IvanKenevich/furuta-pendulum/docs/TB9051FTG_pinout.jpg

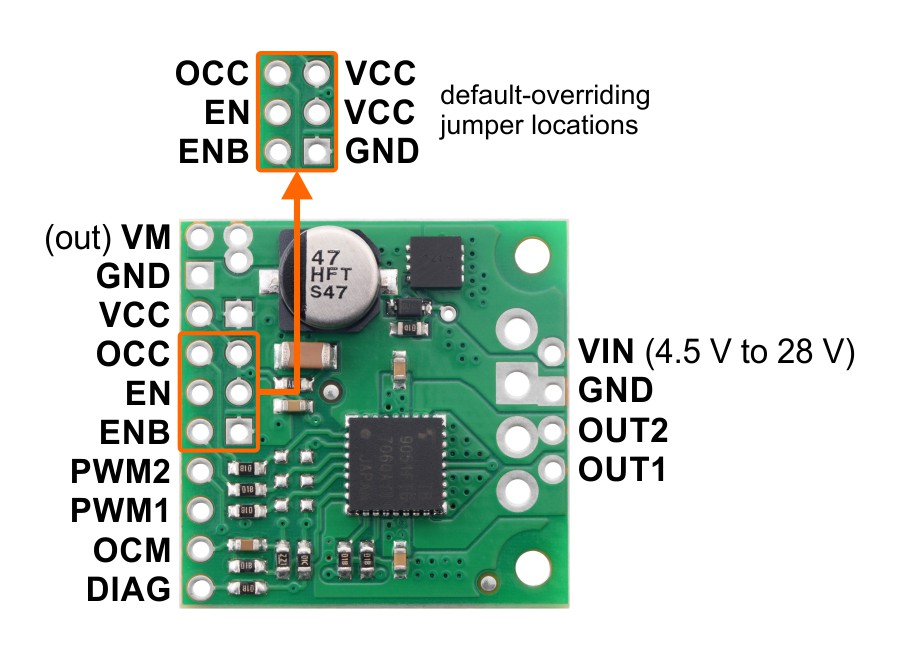
docs/TB9051FTG_pinout.jpg
