IvanKenevich/furuta-pendulum/README.md

# furuta-pendulum

Inverted rotary pendulum
