IvanKenevich/furuta-pendulum/code/MATLAB/motor_freq_response/response_amplitudes.png

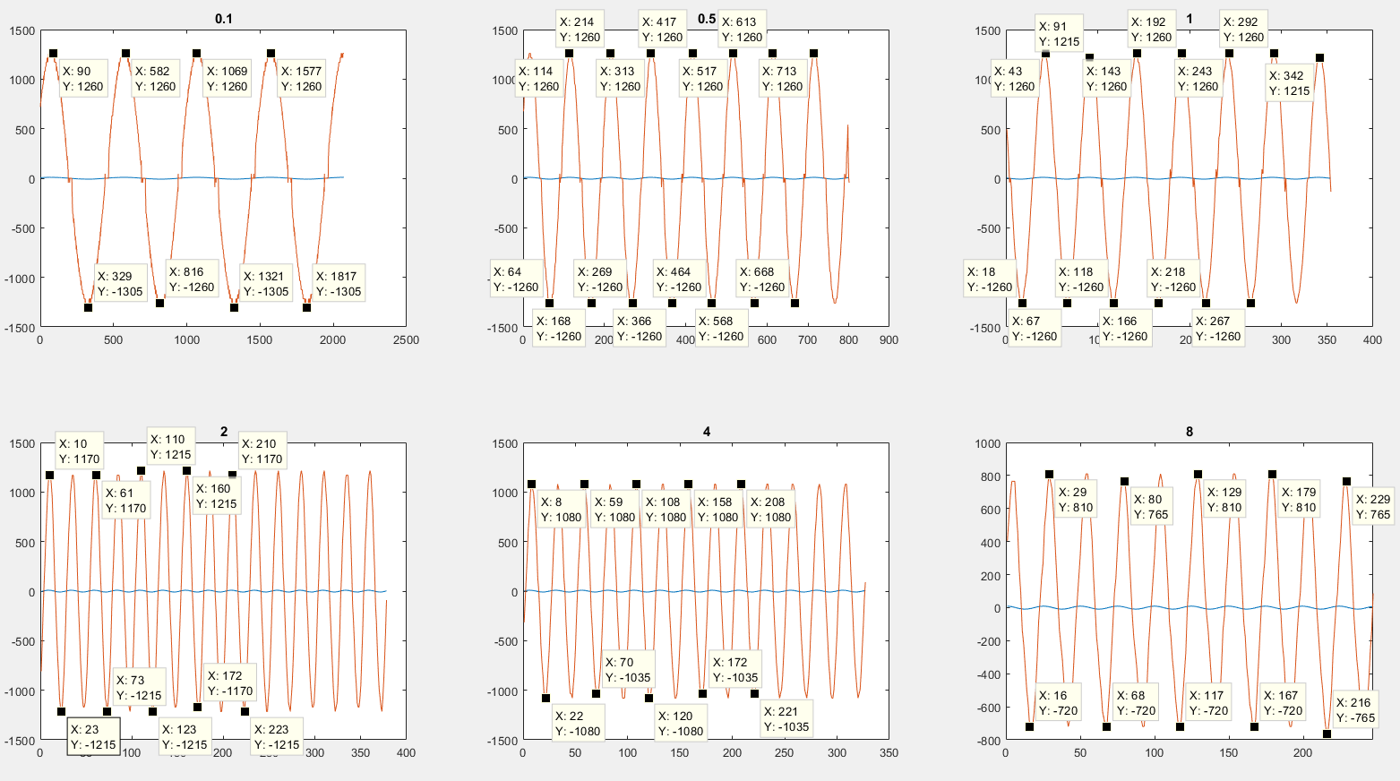
code/MATLAB/motor_freq_response/response_amplitudes.png
