IvanKenevich/furuta-pendulum/code/motor_freq_response/0.1hz_8.58v.png

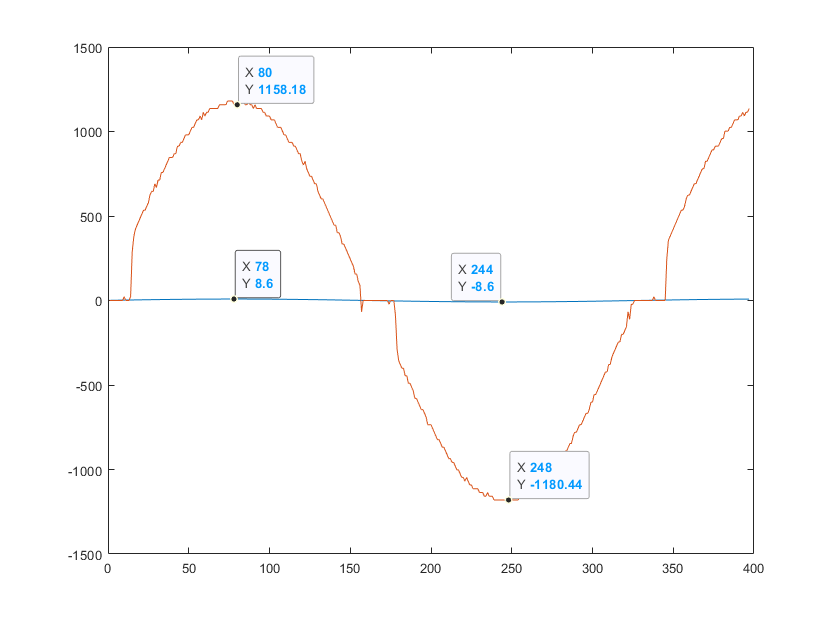
code/motor_freq_response/0.1hz_8.58v.png
