IvanKenevich/furuta-pendulum/code/motor_freq_response/0.5hz_5v.png

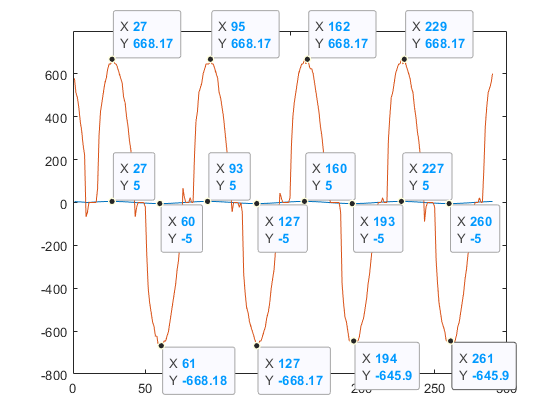
code/motor_freq_response/0.5hz_5v.png
