IvanKenevich/furuta-pendulum/code/motor_freq_response/1hz_5v_phase.png

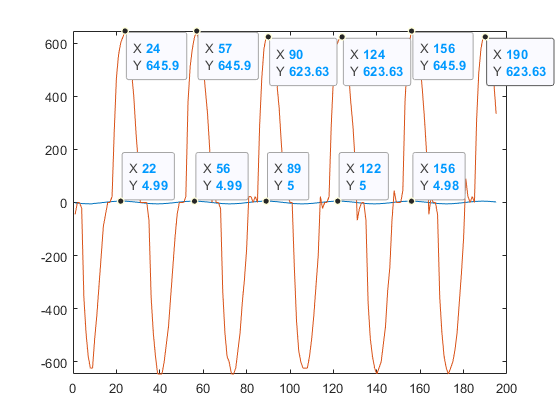
code/motor_freq_response/1hz_5v_phase.png
