IvanKenevich/furuta-pendulum/code/motor_freq_response/2hz_5v.png

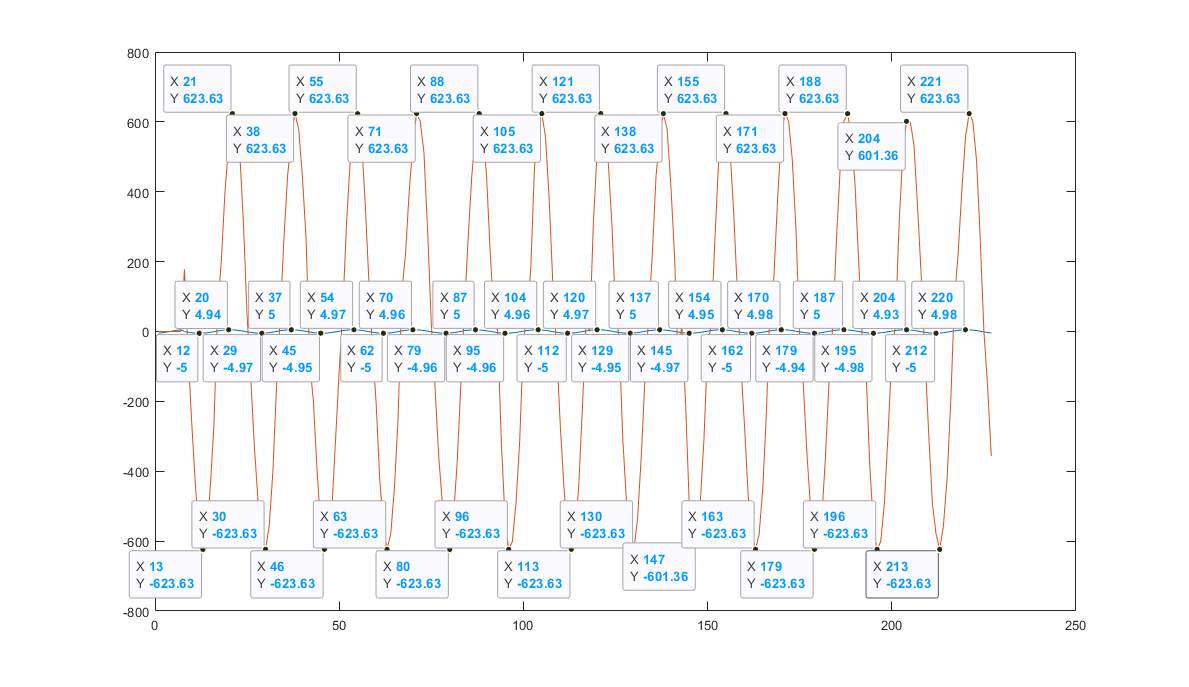
code/motor_freq_response/2hz_5v.png
