IvanKenevich/furuta-pendulum/cad/AMT10/CUI_DEVICES_CUI_DEVICES_AMT103-D0048-I3000-S.sldasm

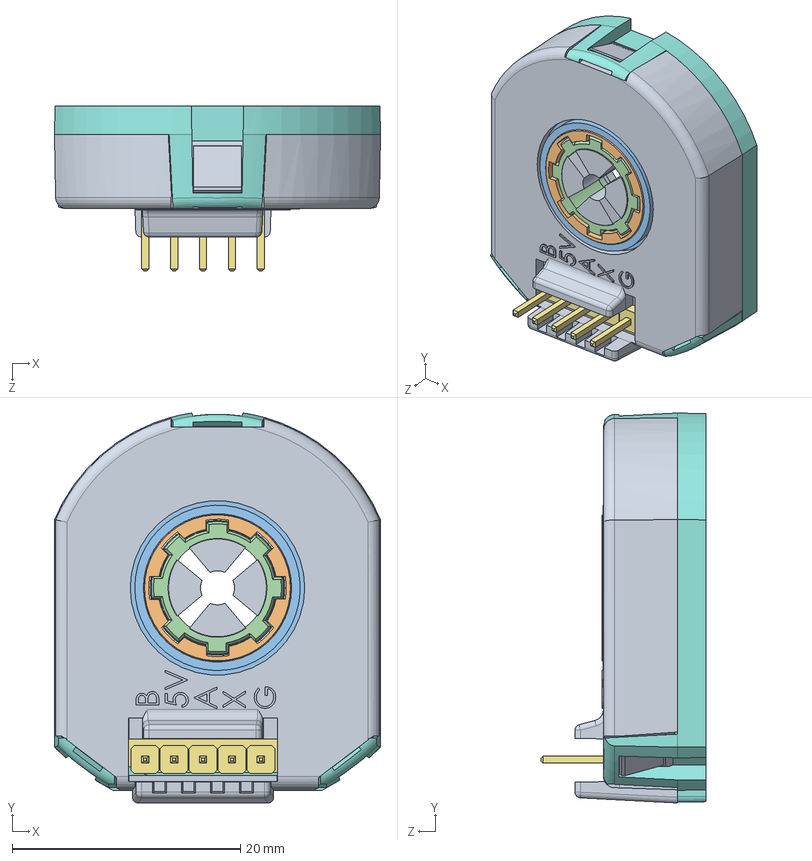
[picture p12: CAD file, 2023-09-13]
cad/AMT10/CUI_DEVICES_CUI_DEVICES_AMT103-D0048-I3000-S.sldasm
28.6 x 34.2 x 14.5 mm
CUI_DEVICES_AMT-Sleeve-REV-D(3 mm)
CUI_DEVICES_AMT-Hub-Top-REV-D1
CUI_DEVICES_AMT-Hub-Bottom-REV-B
CUI_DEVICES_AMT10X-Shaft-Adaptor-REV-E
CUI_DEVICES_Receiver-board
CUI_DEVICES_Rotor-board-REV F
CUI_DEVICES_Transmitter-board AMT10(AMT-103)
CUI_DEVICES_AMT-103-Base-REV-K(Default)
CUI_DEVICES_AMT-103-Top-Cover-REV-I
