IvanKenevich/furuta-pendulum/cad/arm1_assembly.SLDASM

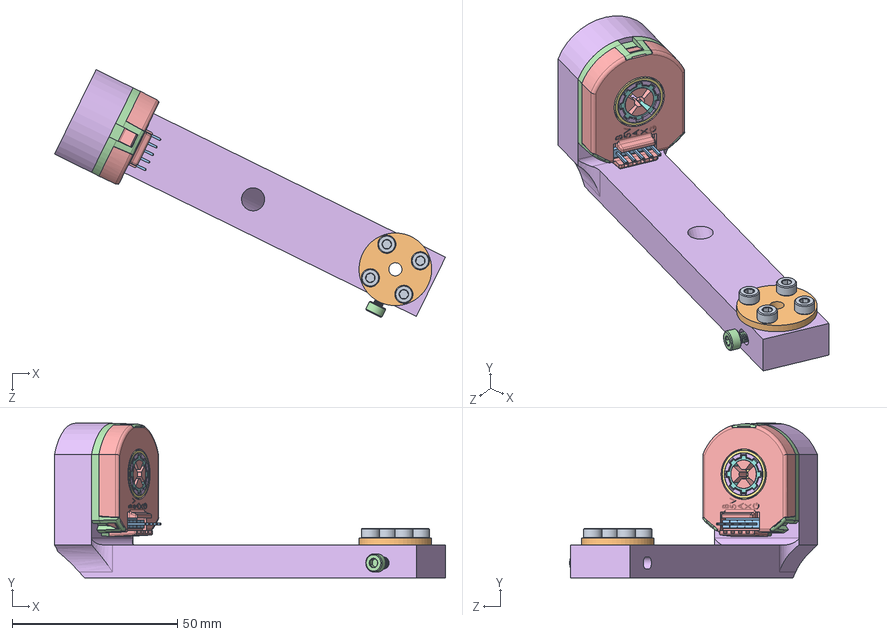
[picture p13: CAD file, 2023-09-13]
cad/arm1_assembly.SLDASM
118.4 x 46.8 x 75.0 mm
M3-12 x 4
M4 Shaft Coupler
M3 Nut x 4
M3-10
CUI_DEVICES_AMT-Sleeve-REV-D(3 mm)
CUI_DEVICES_AMT-Hub-Top-REV-D1
CUI_DEVICES_AMT-Hub-Bottom-REV-B
CUI_DEVICES_AMT10X-Shaft-Adaptor-REV-E
CUI_DEVICES_Receiver-board
CUI_DEVICES_Rotor-board-REV F
CUI_DEVICES_Transmitter-board AMT10(AMT-103)
CUI_DEVICES_AMT-103-Base-REV-K(Default)
CUI_DEVICES_AMT-103-Top-Cover-REV-I
Copy of Part2^arm1_assembly
8mm_bearing
