IvanKenevich/furuta-pendulum/cad/pcb/LM78L05ACZ_NOPB/LM78L05ACZ_NOPB.step

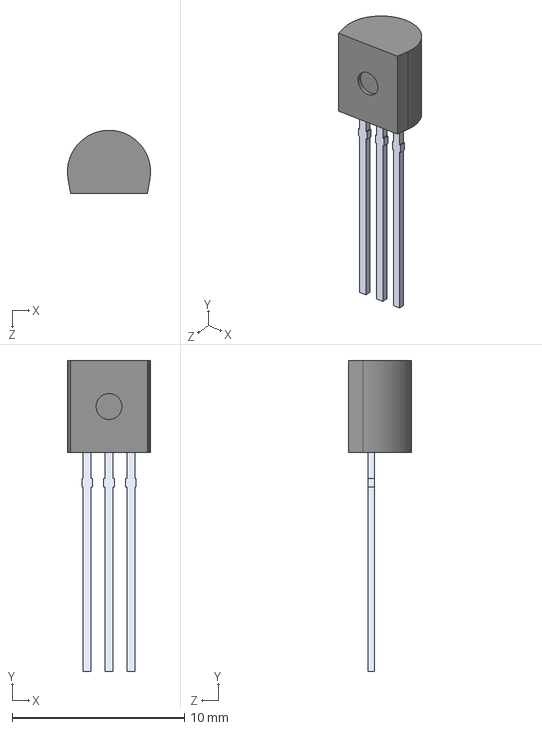
[picture p14: CAD file, 2025-07-25]
cad/pcb/LM78L05ACZ_NOPB/LM78L05ACZ_NOPB.step
4.82 x 18.0 x 3.68 mm
