IvanKenevich/furuta-pendulum/cad/Slip_Ring_B07XMJT65N.SLDPRT

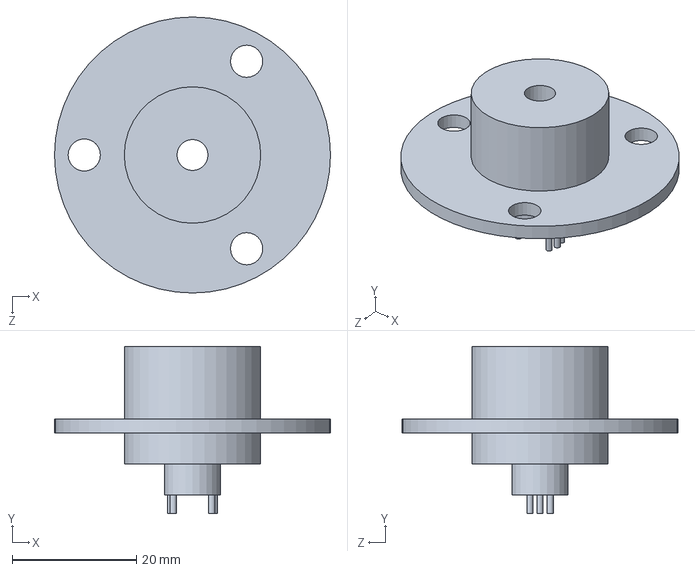
[picture p15: CAD file, 2023-09-13]
cad/Slip_Ring_B07XMJT65N.SLDPRT
44.5 x 27.0 x 44.5 mm
