IvanKenevich/furuta-pendulum/cad/M4 Shaft Coupler.SLDPRT

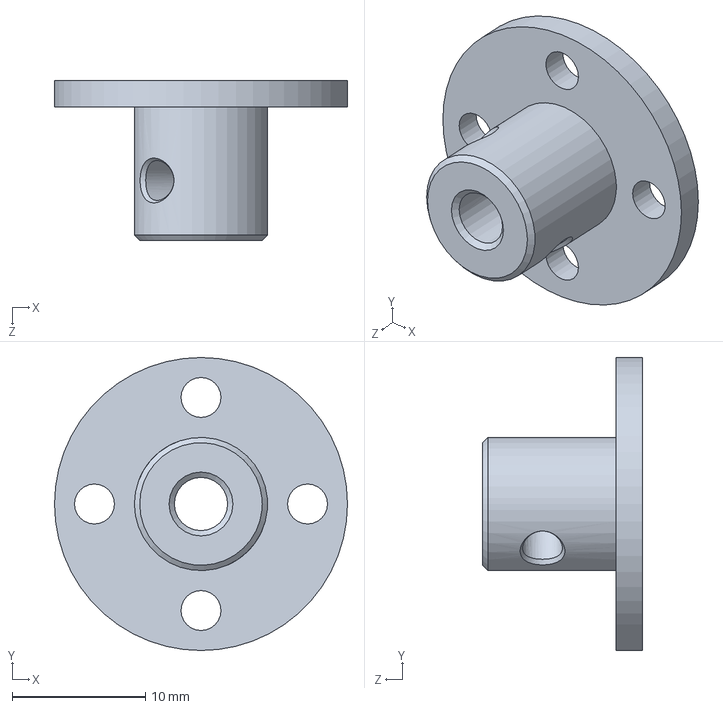
[picture p16: CAD file, 2023-09-13]
cad/M4 Shaft Coupler.SLDPRT
22.0 x 22.0 x 12.0 mm
