IvanKenevich/furuta-pendulum/cad/25d-metal-gearmotor-34-47-encoder.step.SLDPRT

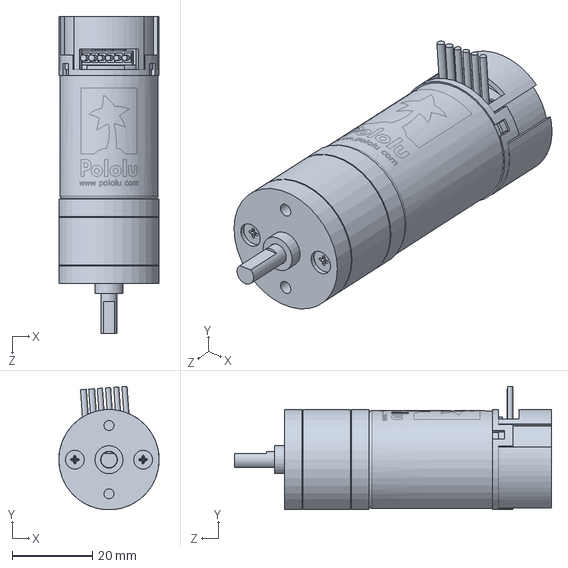
[picture p17: CAD file, 2023-09-13]
cad/25d-metal-gearmotor-34-47-encoder.step.SLDPRT
25.0 x 30.7 x 78.9 mm
