IvanKenevich/furuta-pendulum/cad/8mm_bearing.SLDPRT

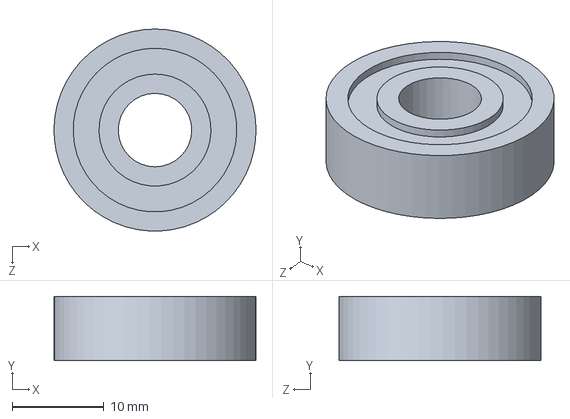
[picture p18: CAD file, 2023-09-13]
cad/8mm_bearing.SLDPRT
22.0 x 7.00 x 22.0 mm
