IvanKenevich/furuta-pendulum/cad/arm2_combined.SLDPRT

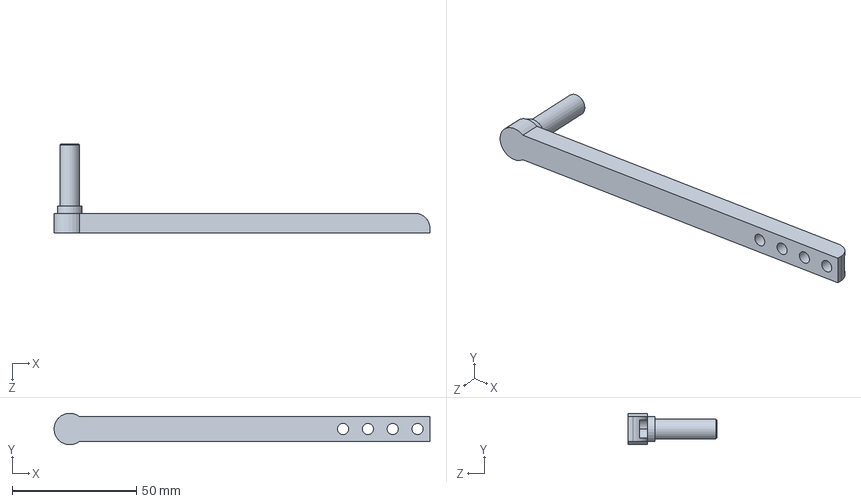
[picture p19: CAD file, 2023-09-13]
cad/arm2_combined.SLDPRT
151.3 x 12.7 x 36.0 mm
