IvanKenevich/furuta-pendulum/cad/M4 socket heads.SLDPRT

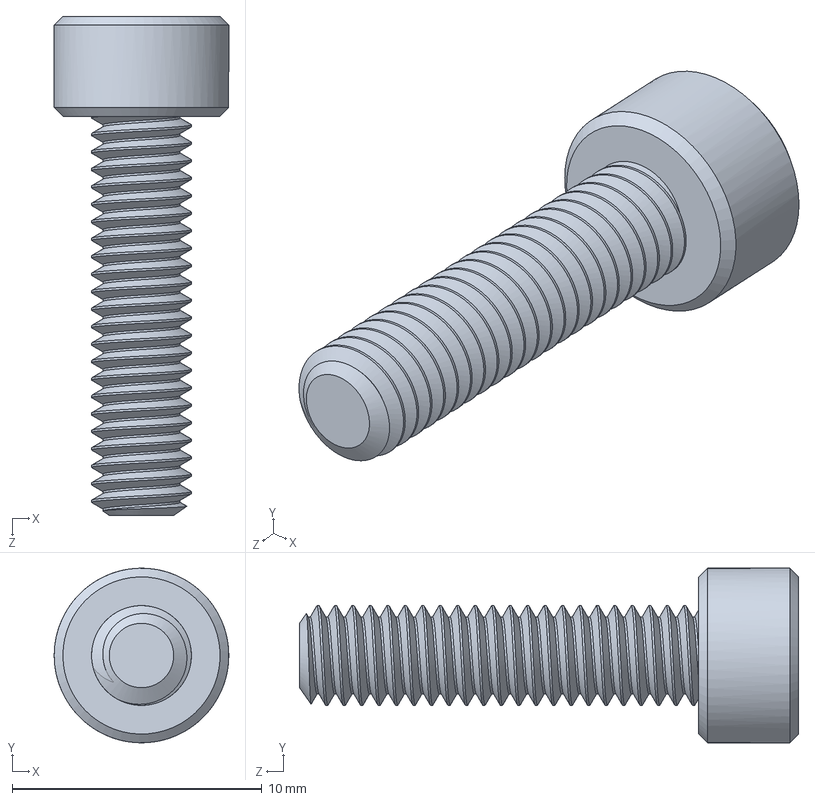
[picture p20: CAD file, 2023-09-13]
cad/M4 socket heads.SLDPRT
7.00 x 7.00 x 20.0 mm
