IvanKenevich/furuta-pendulum/cad/acrylic_base.SLDPRT

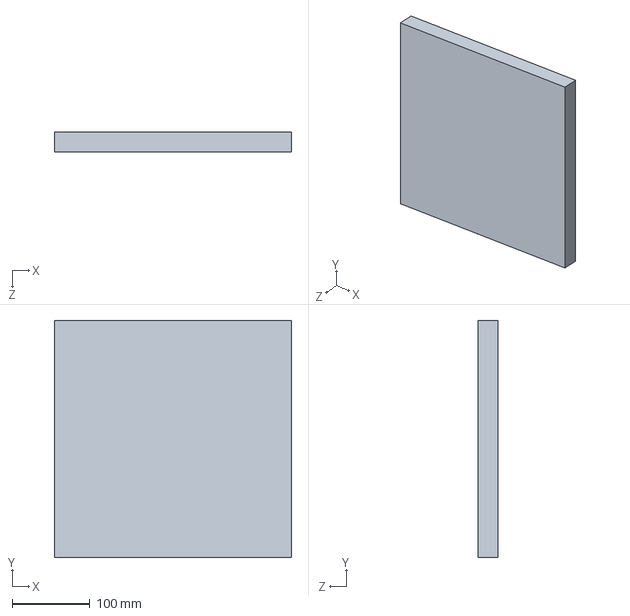
[picture p21: CAD file, 2023-09-13]
cad/acrylic_base.SLDPRT
304.8 x 304.8 x 25.4 mm
