IvanKenevich/furuta-pendulum/cad/shaft_coupler.SLDPRT

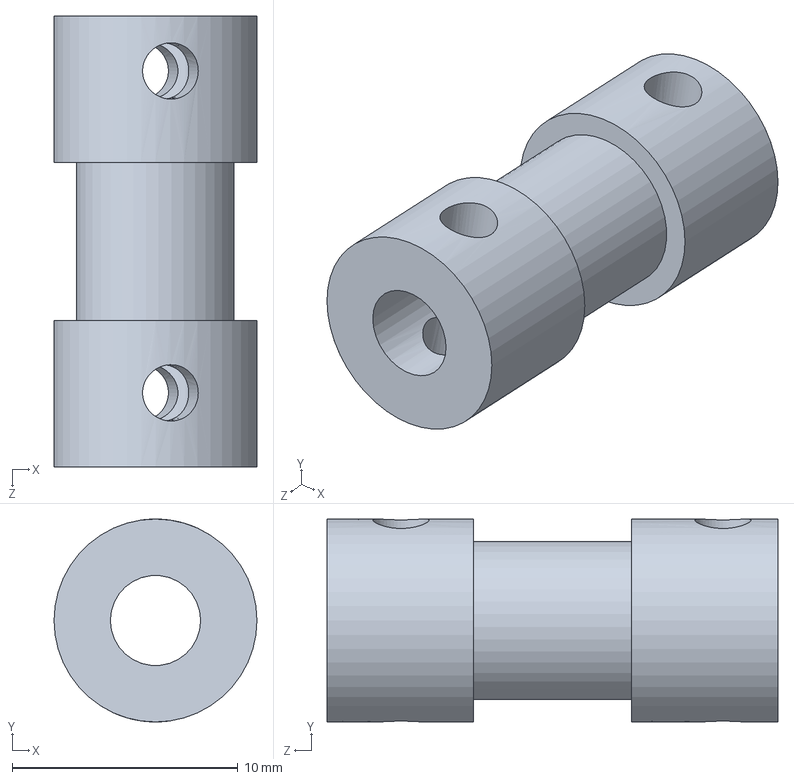
[picture p22: CAD file, 2023-09-13]
cad/shaft_coupler.SLDPRT
9.00 x 9.00 x 20.0 mm
