IvanKenevich/furuta-pendulum/cad/top plate.SLDPRT

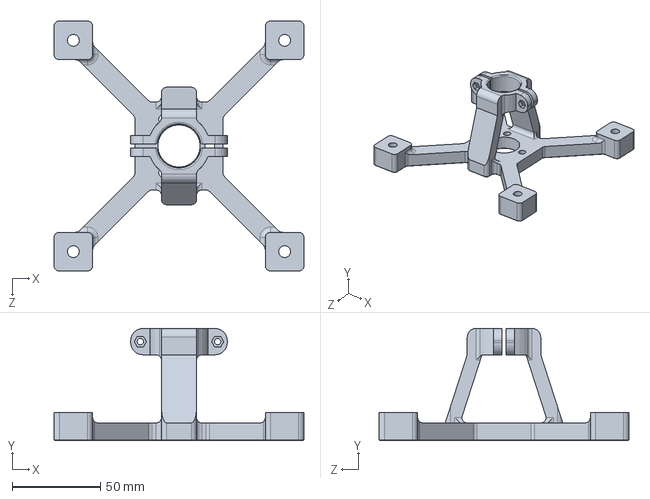
[picture p23: CAD file, 2023-08-10]
cad/top plate.SLDPRT
142.0 x 63.7 x 142.0 mm
