IvanKenevich/furuta-pendulum/cad/6436K5_Clamping Two-Piece Shaft Collar.SLDPRT

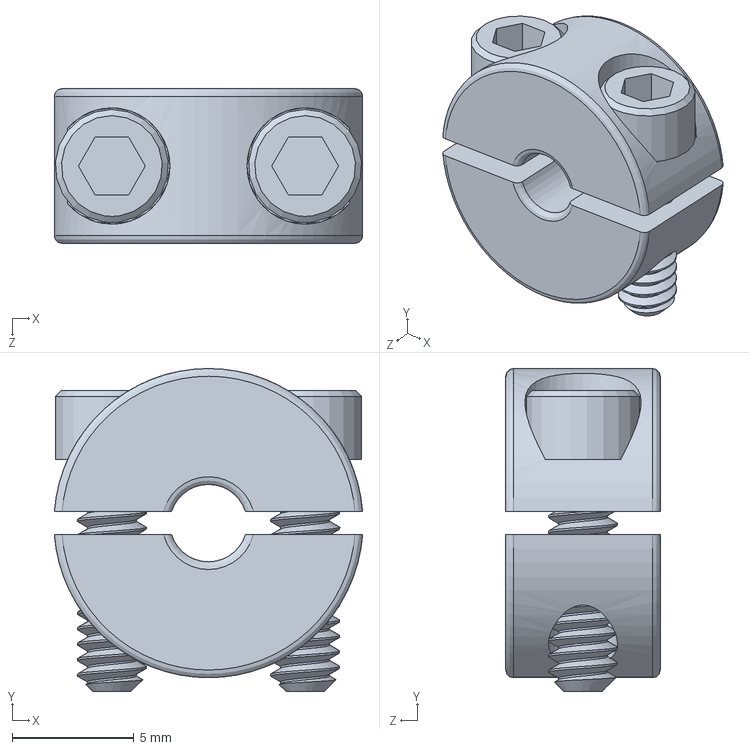
[picture p24: CAD file, 2023-06-01]
cad/6436K5_Clamping Two-Piece Shaft Collar.SLDPRT
12.7 x 13.3 x 6.35 mm
