IvanKenevich/furuta-pendulum/cad/spacer_disk.SLDPRT

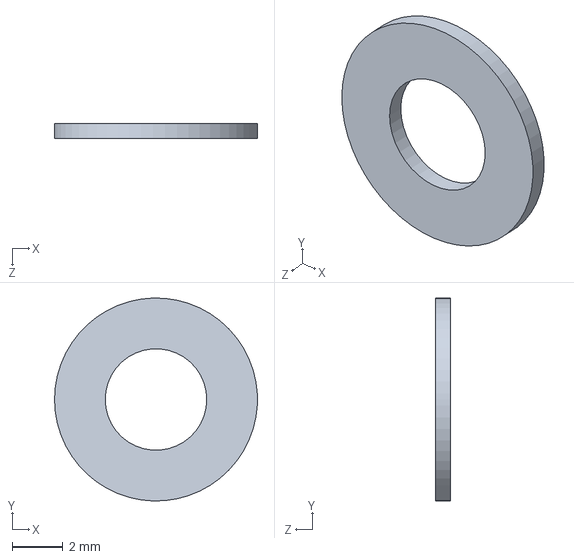
[picture p25: CAD file, 2023-05-31]
cad/spacer_disk.SLDPRT
8.00 x 8.00 x 0.6 mm
