IvanKenevich/furuta-pendulum/cad/bottom plate.SLDPRT

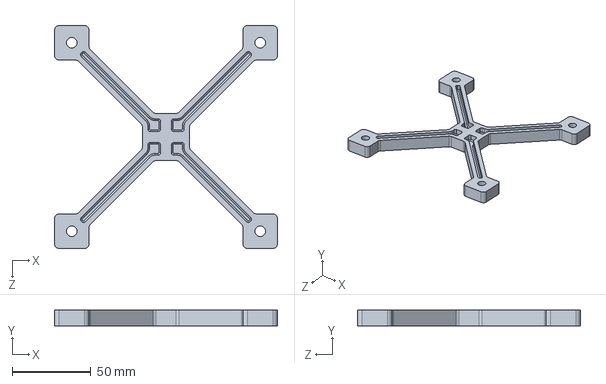
[picture p26: CAD file, 2023-05-23]
cad/bottom plate.SLDPRT
142.0 x 10.0 x 142.0 mm
