IvanKenevich/furuta-pendulum/cad/pololu-universal-aluminum-mounting-hub-for-4mm-shaft-m3-holes.step

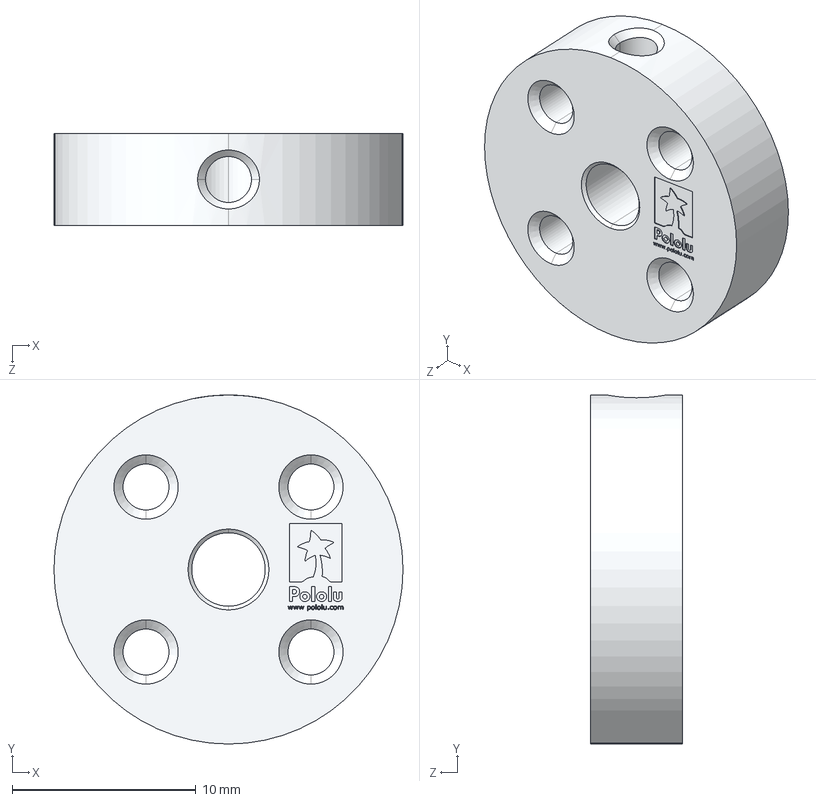
[picture p27: CAD file, 2023-05-05]
cad/pololu-universal-aluminum-mounting-hub-for-4mm-shaft-m3-holes.step
19.0 x 19.0 x 5.00 mm
