IvanKenevich/furuta-pendulum/cad/mending bracket.SLDPRT

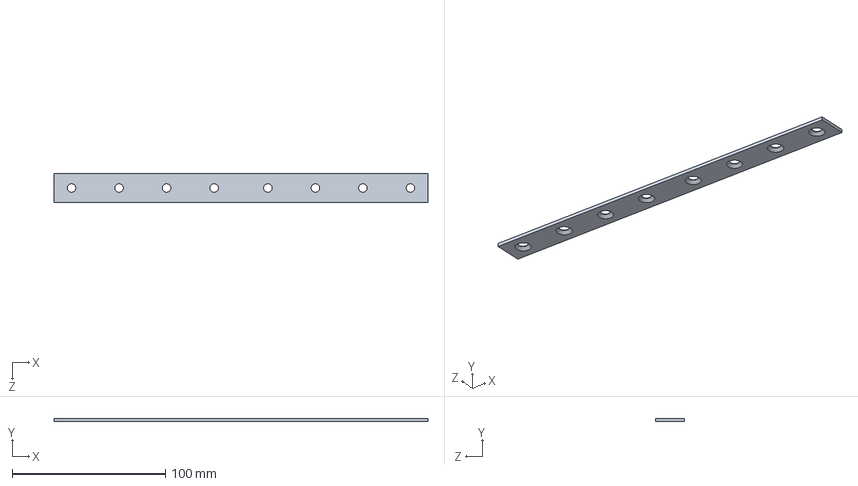
[picture p28: CAD file, 2023-05-05]
cad/mending bracket.SLDPRT
243.8 x 2.03 x 19.1 mm
