IvanKenevich/furuta-pendulum/cad/arm2_assembly.SLDASM

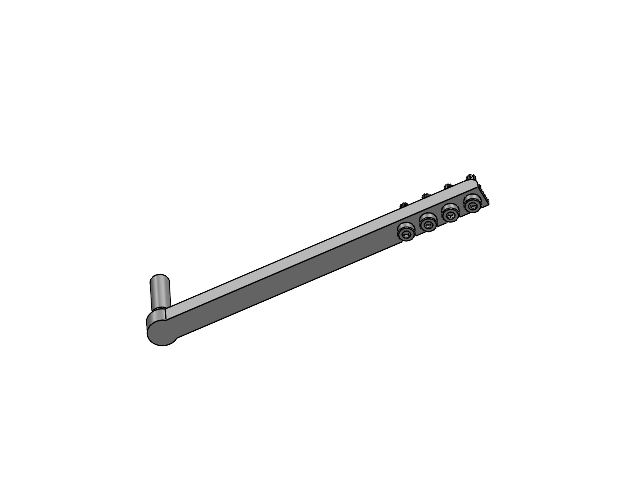
[picture p29: CAD file, 2023-09-13]
cad/arm2_assembly.SLDASM
arm2_combined
M4 Nut x 4
M4 socket heads x 4
