IvanKenevich/furuta-pendulum/(list of files, cad)

Other CAD files:
cad/AMT10/CUI_DEVICES_AMT-Sleeve-REV-D(3 mm).sldprt
cad/AMT10/CUI_DEVICES_AMT-103-Top-Cover-REV-I.sldprt
cad/AMT10/CUI_DEVICES_AMT-Hub-Top-REV-D1.sldprt
cad/AMT10/CUI_DEVICES_Receiver-board.sldprt
cad/AMT10/CUI_DEVICES_AMT-103-Base-REV-K(Default).sldprt
cad/AMT10/CUI_DEVICES_AMT10X-Shaft-Adaptor-REV-E.sldprt
cad/AMT10/CUI_DEVICES_AMT-Hub-Bottom-REV-B.sldprt
cad/AMT10/CUI_DEVICES_Rotor-board-REV F.sldprt
cad/AMT10/CUI_DEVICES_Transmitter-board AMT10(AMT-103).sldprt
cad/25d-metal-gearmotor-34-47-encoder.step
cad/1327K93_Rotary Shaft.SLDPRT
cad/5544T231_Tight-Tolerance 12L14 Carbon Steel Rod.SLDPRT
cad/6103K24_Swivel Leveling Mount.SLDPRT
cad/6338K561_Oil-Embedded Flanged Sleeve Bearing.SLDPRT
cad/6436K12_Clamping Two-Piece Shaft Collar.SLDPRT
cad/8632T132_D-Profile Rotary Shaft.SLDPRT
cad/8920K181_Low-Carbon Steel Rod.SLDPRT
cad/8961K87_Steel DIN 3 Rail.SLDPRT
cad/90281A102_Black-Oxide Steel Setup Stud.SLDPRT
cad/90490A029_Low-Strength Steel Hex Nut.SLDPRT
cad/91290A111_Alloy Steel Socket Head Screw.SLDPRT
cad/M3 Nut.SLDPRT
cad/M3-10.SLDPRT
cad/M3-12.SLDPRT
cad/M4 Nut.SLDPRT
cad/top plate_v1.SLDPRT
