IvanKenevich/furuta-pendulum/(threads)

Thread 1 (2023-10-03):

Try classical controller

IvanKenevich, 2023-10-03:
Design PID and compare with state space

IvanKenevich, 2024-01-26:
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

IvanKenevich, 2024-01-26:
Need to find Ps from equations of motion (linearize). Cs are designed with classical controller design methods.
R_theta2 = 0 always.

This seems like a better method than trying to extract theta_2 transfer function using `ss2tf()`.

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

IvanKenevich, 2024-01-30:
$P_{\theta_2}$ appears plausible to find. Use derived kinematics of linear inverted pendulum to skip that math and see if you can go strait to transfer function of $\theta_2/\dot{\theta}_1$

IvanKenevich, 2024-02-01:
From the math, it turns out

$\displaystyle\frac{\theta_2}{\dot{\theta}_1} = $

$\displaystyle\frac{L_1 m l_{2}s^3}{(J_{2zz-cg}+m l_{2}^2)s^2 + b_2 s - mg l_{2}}$

IvanKenevich, 2025-03-03:
Evaluate later after doing other things

Thread 12 (2023-10-03):

Dual motor system

IvanKenevich, 2023-10-03:
one with high torque and backlash, other with low torque no backlash, have benefits of both

Thread 13 (2023-10-03):

Dual motor system

IvanKenevich, 2023-10-03:
opposing motors with anti-backlash hardware

IvanKenevich, 2025-03-04:
Do some dedicated thinking about this to tell if this is dumb or not. Not specific to this project.

Thread 14 (2023-10-03):

Single direct drive motor

IvanKenevich, 2023-10-03:
Get rid of backlash by getting a direct drive motor that works.

Closed 2025-03-04.

Thread 15 (2023-10-03):

Precision gearbox

IvanKenevich, 2023-10-03:
Buy a gearbox that has high precision to reduce backlash

IvanKenevich, 2025-03-04:
Do some dedicated thinking about this to tell if this is dumb or not. Not specific to this project.

Closed 2025-03-04.

Thread 16 (2023-10-03):

Investigate more different ways of measuring motor parameters

IvanKenevich, 2023-10-03:
measure each par manually and compare to freq response solved versions

ask on stack exchange: does the motor have the same friction coeffficent when power or unpowered

IvanKenevich, 2025-03-03:
Look into which motor parameters we can measure manually and how trustworthy the measurements would be.

Try finding the answer to second question (ChatGPT?)

Thread 19 (2023-10-03):

Learn how to model nonlinearities

IvanKenevich, 2023-10-03:
backlash, stiction

IvanKenevich, 2025-03-03:
Model on a simplified system - motor with inertia wheel. Make sure simulation matches reality.

Thread 3 (2023-10-03):

Non-linear controller

IvanKenevich, 2023-10-03:
Compare performance to linear

IvanKenevich, 2025-03-04:
Another project. If you want, look into cancelling backlash with your controller on this project to improve performance.

Closed 2025-03-04.

Thread 4 (2023-10-03):

Modulo arm 1

IvanKenevich, 2023-10-03:
60 degree modulo. Make sure it resets upon swingup (there is currently a bug where it uses reference variable and does not reset).

IvanKenevich, 2025-03-03:
Run it, see how it works

Thread 8 (2023-10-03):

Investigate why current matters for furuta but not RWIP

IvanKenevich, 2023-10-03:
look at the magnitudes of torques/delta Is/whatever that are caused by the current state variable

IvanKenevich, 2025-03-04:
Look at it.
