IvanKenevich/furuta-pendulum/cad/pcb/furuta-pendulum-pcb.kicad_pcb

## KiCad design cad/pcb/furuta-pendulum-pcb.kicad_pcb (2025-12-10)

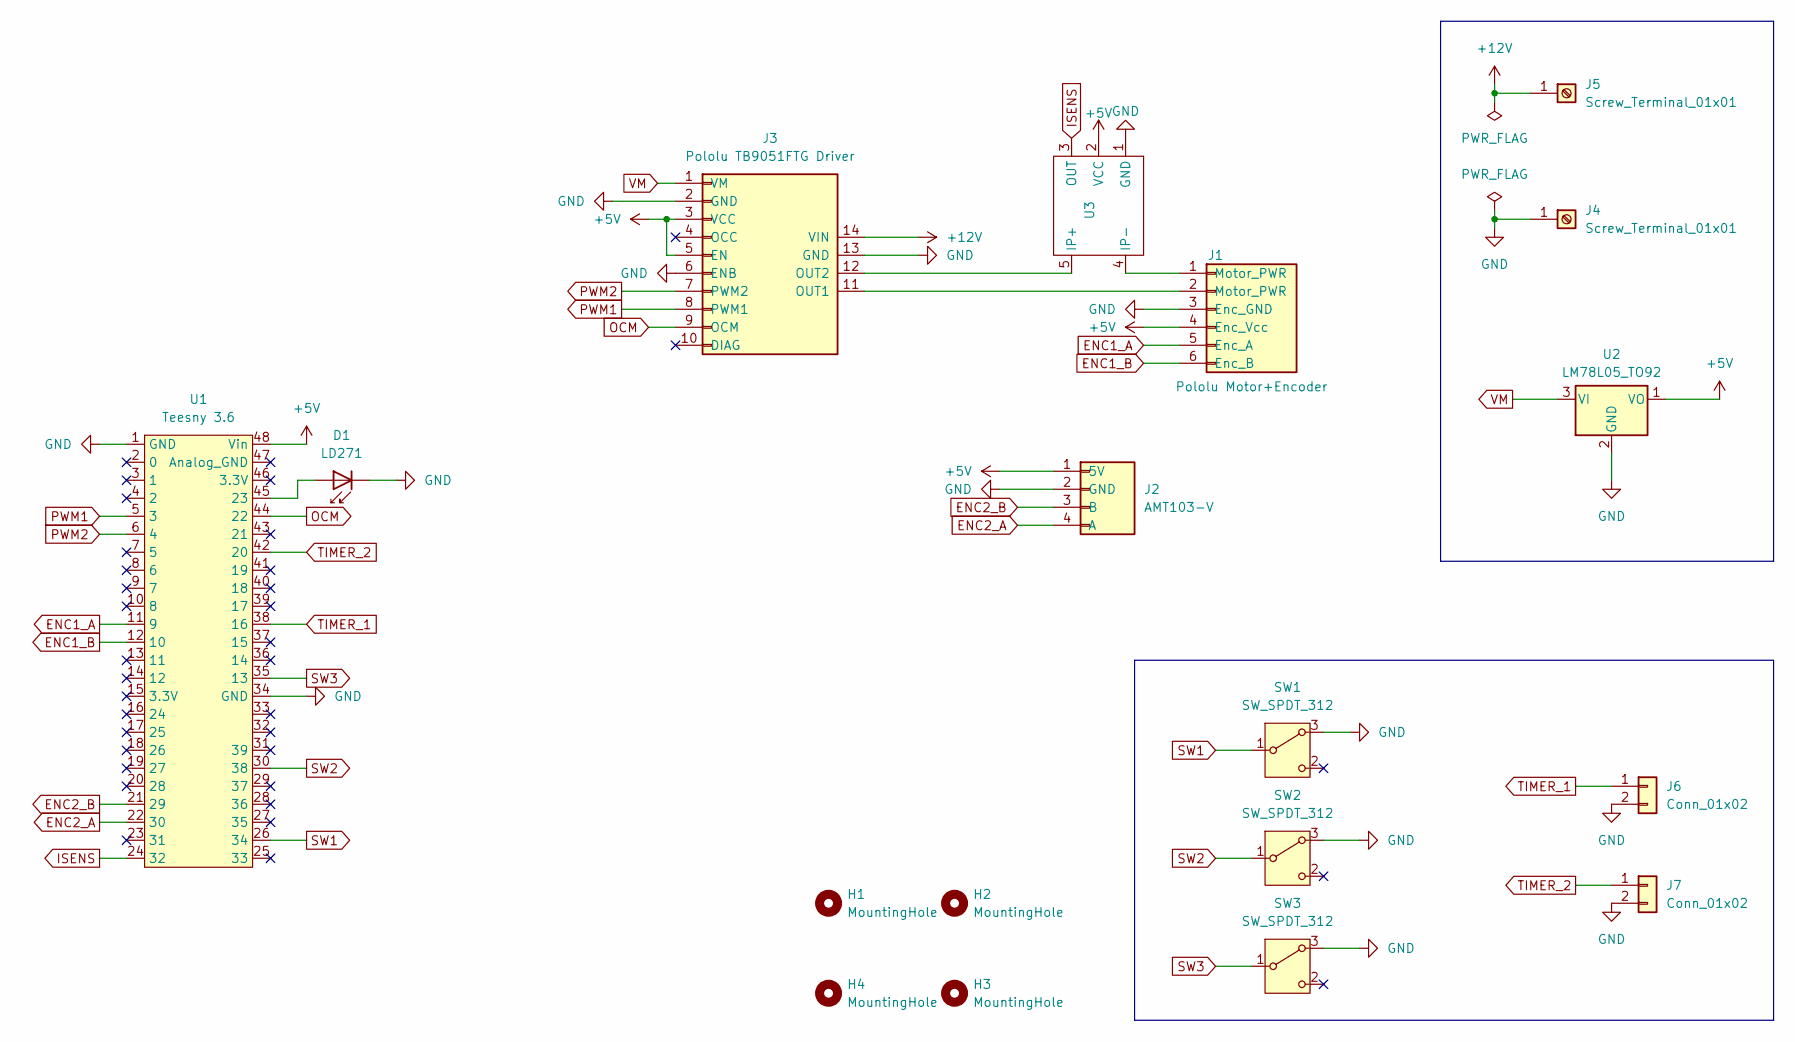
[picture p30: schematic furuta-pendulum-pcb.kicad_sch]

Parts:
D1: LD271; LED_D5.0mm_IRGrey
H1, H2, H3, H4: MountingHole; MountingHole_2.2mm_M2
J1: Pololu Motor+Encoder; PinHeader_1x06_P2.54mm_Vertical
J2: AMT103-V; PinSocket_1x04_P2.54mm_Vertical
J3: Pololu TB9051FTG Driver; Pololu TB9051FTG motor driver
J4, J5: Screw_Terminal_01x01; CalTest_CT3151
J6, J7: Conn_01x02; PinHeader_1x02_P2.54mm_Vertical
SW1, SW2, SW3: SW_SPDT_312; Flat Toggle Switch
U1: Teesny 3.6; Teensy 3.6
U2: LM78L05_TO92; TO-92_Inline
U3: Pololu ACS724 Current Sensor

Connections:
+5V: J1.4 (Enc_Vcc), J2.1 (5V), J3.3 (VCC), J3.5 (EN), U1.48 (Vin), U2.1 (VO), U3.2 (VCC)
+12V: J3.14 (VIN), J5.1
ENC1_A: J1.5 (Enc_A), U1.11 (9)
ENC1_B: J1.6 (Enc_B), U1.12 (10)
ENC2_A: J2.4 (A), U1.22 (30)
ENC2_B: J2.3 (B), U1.21 (29)
GND: D1.1 (K), J1.3 (Enc_GND), J2.2 (GND), J3.2 (GND), J3.6 (ENB), J3.13 (GND), J4.1, J6.2, J7.2, SW1.3 (A), SW2.3 (A), SW3.3 (A), U1.1 (GND), U1.34 (GND), U2.2 (GND), U3.1 (GND)
ISENS: U1.24 (32), U3.3 (OUT)
unnamed: D1.2 (A), U1.45 (23)
unnamed: J1.2 (Motor_PWR), J3.11 (OUT1)
unnamed: J3.12 (OUT2), U3.5 (IP+)
unnamed: J1.1 (Motor_PWR), U3.4 (IP-)
OCM: J3.9 (OCM), U1.44 (22)
PWM1: J3.8 (PWM1), U1.5 (3)
PWM2: J3.7 (PWM2), U1.6 (4)
SW1: SW1.1 (B), U1.26 (34)
SW2: SW2.1 (B), U1.30 (38)
SW3: SW3.1 (B), U1.35 (13)
TIMER_1: J6.1, U1.38 (16)
TIMER_2: J7.1, U1.42 (20)
VM: J3.1 (VM), U2.3 (VI)

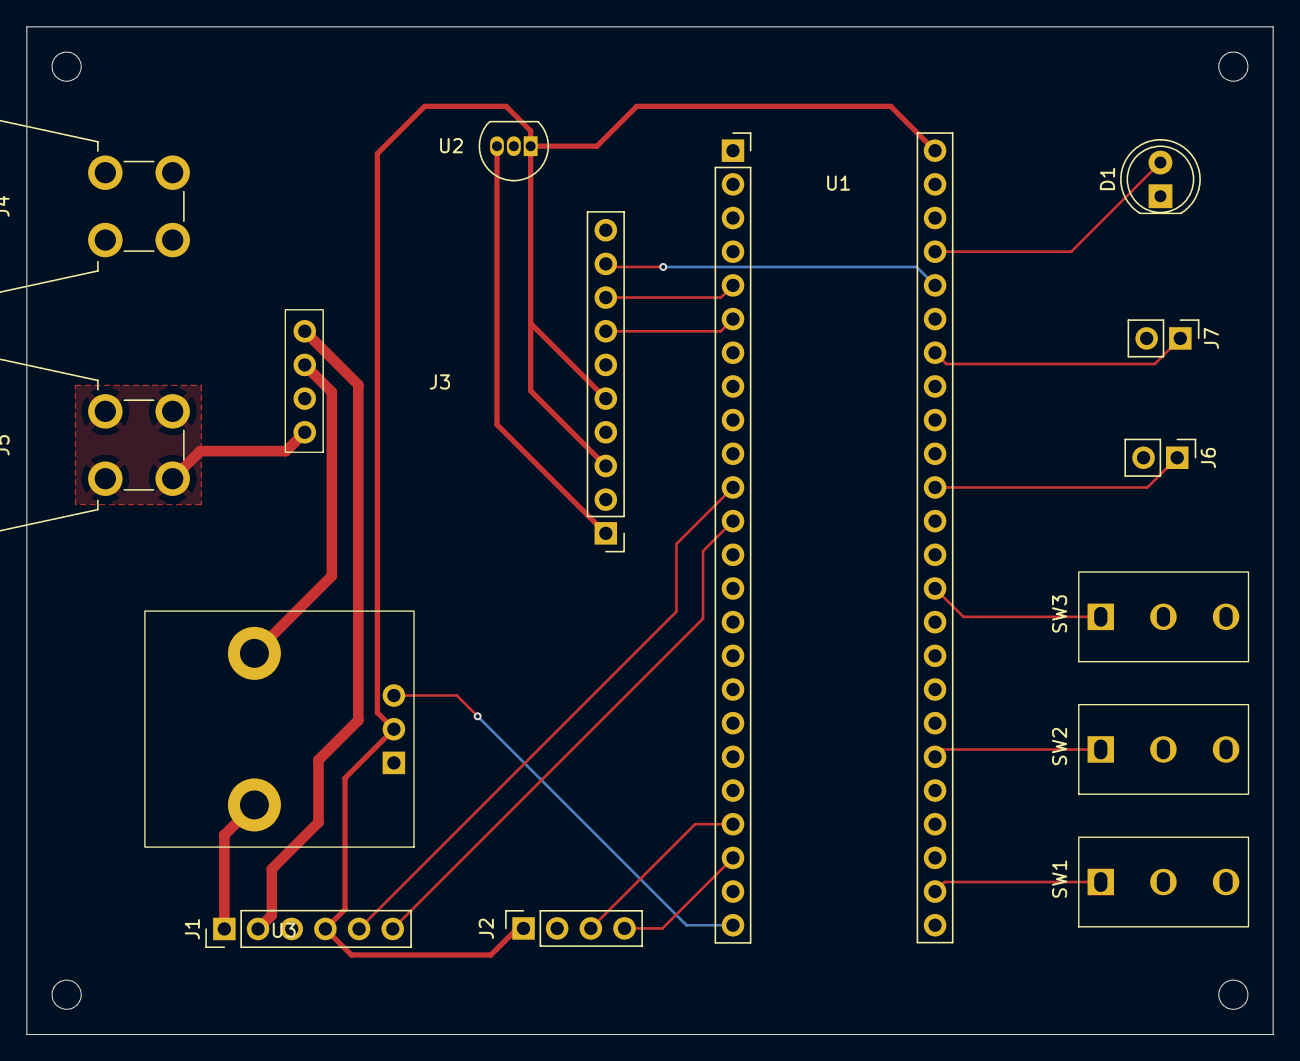
[picture p31: board furuta-pendulum-pcb.kicad_pcb from above]

Board: 2 copper layers, 94.0 x 76.0 mm, 18 parts (0 on the bottom side), 21 nets.
