IvanKenevich/furuta-pendulum/(commit log)

2023-05-05 add existing files
    [1327K93_Rotary Shaft.SLDPRT, 25d-metal-gearmotor-34-47-encoder.step, 25d-metal-gearmotor-34-47-encoder.step.SLDPRT, 5544T231_Tight-Tolerance 12L14 Carbon Steel Rod.SLDPRT, 6103K24_Swivel Leveling Mount.SLDPRT, 6338K561_Oil-Embedded Flanged Sleeve Bearing.SLDPRT, 6436K12_Clamping Two-Piece Shaft Collar.SLDPRT, 6436K5_Clamping Two-Piece Shaft Collar.SLDPRT]
2023-05-07 switch to elapsedMillis, remove unused code
2023-05-07 add motor datasheet
2023-05-08 collect motor identification data, move old identification data into separate folder
2023-05-10 place all matlab code into a separate folder add Jacob's RWIP matlab code add experimentally determined model transfer function
    [Frequency Response 2.0.xlsx]
2023-05-11 add code to simulate damped unpowered arm
2023-05-11 add teensy code to collect arm damping data add first dataset collected from arm
2023-05-13 collect dataset with clip collect info about arm and clip rename original dataset add code to plot simulated on top of real oscillations
    [arm2_damping.ino]
2023-05-17 add state-space formulation that includes motor dynamics but with inductance assumed as zero change reference position so that arm 1 doesn't try to go to zero add file with ideas
2023-05-18 add motor dynamics to odefun_torque.m change motor damping and other constants to values from motor id add state-space fomulation that does not ignor inductance minor plotting changes
2023-05-20 add current back into error calculation, change how arm speeds are plotted
2023-05-23 Redesign arm 1 attachment to motor shaft, remove weight savings features, add wire routing hole
    [M3 Nut.SLDPRT, M3-12.SLDPRT, M4 Shaft Coupler.SLDPRT]
2023-05-23 commit the rest of work from last commit
    [1327K93_Rotary Shaft.SLDPRT, 5544T231_Tight-Tolerance 12L14 Carbon Steel Rod.SLDPRT, 6103K24_Swivel Leveling Mount.SLDPRT, 6338K561_Oil-Embedded Flanged Sleeve Bearing.SLDPRT, 6436K5_Clamping Two-Piece Shaft Collar.SLDPRT, 90281A102_Black-Oxide Steel Setup Stud.SLDPRT, 90490A029_Low-Strength Steel Hex Nut.SLDPRT, CUI_DEVICES_AMT-103-Base-REV-K(Default).sldprt]
2023-05-23 change top plate design to include recess for nuts
    [top plate.SLDPRT]
2023-05-24 add bolt holes to arm2, add bolts and nuts through the holes
    [M4 socket heads.SLDPRT]
2023-05-25 rotate setscrew hole on shaft coupler, add M3-10 bolt, add slot for setscrew in arm1
    [M3-10.SLDPRT, M3-12.SLDPRT, M4 Shaft Coupler.SLDPRT]
2023-05-31 add density to most relevant parts (not all yet), make arm2 thicker at the shaft section, add spacer disks between the bearings
    [1327K93_Rotary Shaft.SLDPRT, 6338K561_Oil-Embedded Flanged Sleeve Bearing.SLDPRT, 6436K5_Clamping Two-Piece Shaft Collar.SLDPRT, CUI_DEVICES_AMT-103-Base-REV-K(Default).sldprt, CUI_DEVICES_AMT-103-Top-Cover-REV-I.sldprt, CUI_DEVICES_AMT-Hub-Bottom-REV-B.sldprt, CUI_DEVICES_AMT-Hub-Top-REV-D1.sldprt, CUI_DEVICES_AMT-Sleeve-REV-D(3 mm).sldprt]
2023-06-01 finish adding material properties, make sure materials are stored in the materials.sldmat file, fix reference in arm1 that was causing constant rebuilds
    [1327K93_Rotary Shaft.SLDPRT, 6338K561_Oil-Embedded Flanged Sleeve Bearing.SLDPRT, 6436K5_Clamping Two-Piece Shaft Collar.SLDPRT, CUI_DEVICES_AMT-103-Base-REV-K(Default).sldprt, CUI_DEVICES_AMT-103-Top-Cover-REV-I.sldprt, CUI_DEVICES_AMT-Hub-Bottom-REV-B.sldprt, CUI_DEVICES_AMT-Hub-Top-REV-D1.sldprt, CUI_DEVICES_AMT-Sleeve-REV-D(3 mm).sldprt]
2023-06-01 update arm cg positions, total arm masses, inertia tensors
2023-06-07 - reverse directions for both encoders and the motor so that it matches the sign convention established in the paper - change controller interrupt priority to a lower value to minimize chances of los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
    [furuta-pendulum.ino]
2023-06-11 collect dataset with a higher voltage step input
2023-06-11 design_controller.m - switch from fully measured system to realistically measured - add observer design and benchmark - move control law into a separate function
    build_ss_models.m
    - switch from simplified to full inertia tensors
    - create version of full system with realistic measurement matrix
2023-06-12 add digital controller design and begin printng C code
2023-06-14 design_controller.m - add code to print C variable definitions - change Observer call to match new signature
    - comment out the version that saves function handles to get rid of the warning on personal computer when loading mat fie
    Observer.m
    - add explicit handing of observer design for digital systems
    furuta-pendulum.ino
    - add linear algebra implementation of observer and control, still work in progress
    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
2023-06-14 - add swingup timeout logic - add feedback error calculation and reference state
    [furuta-pendulum.ino]
2023-06-15 - fix observer estimation bug where u was used instead of r when multiplying B. Since r is 0, that term can be dropped - remove state 1 reference update since arm1 controller gain will already be set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
    [furuta-pendulum.ino]
2023-06-21 collect dataset2 which is the same controller as dataset1 but with faster printing, add more code to analyze this data
2023-06-21 - collect dataset with improved ICs - collect dataset with improved ICs and V/R current estimation - adjust controller rise time and PMO to make the system reasonably balance
2023-06-21 - ovverride current estimate with V/R - bring swingup back in - reduce max motor voltage - print faster - control gain adjustments because of Tr and PMO changes
2023-08-10 new base design
    [25d-metal-gearmotor-34-47-encoder.step.SLDPRT, 91290A111_Alloy Steel Socket Head Screw.SLDPRT, acrylic_base.SLDPRT, arm1_assembly.SLDASM, arm2_assembly.SLDASM, shaft_coupler.SLDPRT, top plate.SLDPRT]
2023-08-10 - change motor PWM pins to match new layout - change switch pins to match new layout - configure switch pins as pullup - define functions to provide sine and square wave signal sources for testing
2023-08-11 - add new blink LED to replace the one that is used by the switch - add some ideas
    [furuta-pendulum.ino]
2023-08-16 replace motor props with Jacob's motor
2023-08-17 - increase motor voltage thresholds - convert from Ivan to Jacob's motor (resistance, pulses per rev) - add arm1 position reference adjustment - change swingup algorithm to go in another direction af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
2023-08-19 - organize ideas into sections - add current estimation idea
2023-08-22 furuta-pendulum.ino - change pin for switch 2 (LED pin wasn't working as pullup) and assign that switch to swingup request - add swingup and balancing state machine - implement floored division modul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
    state_machine.drawio
    - add speed threshold check to transition from wait to move right
2023-08-24 - ideas review - add eig and eigv discussion to drawio - add encoder datasheet - use error variable in arduino instead of discarding it
    [furuta-pendulum.ino]
2023-09-08 Redesign arm1 and arm2 to convert bushing+shaft assembly of arm2 into a single ball bearing
    [8mm_bearing.SLDPRT, arm1_assembly.SLDASM, arm2_assembly.SLDASM, arm2_combined.SLDPRT]
2023-09-09 Update all statically determinable system properties for new design (mass, length, inertia)
    [8mm_bearing.SLDPRT, CUI_DEVICES_AMT-103-Base-REV-K(Default).sldprt, CUI_DEVICES_AMT-103-Top-Cover-REV-I.sldprt, CUI_DEVICES_AMT-Hub-Bottom-REV-B.sldprt, CUI_DEVICES_AMT-Hub-Top-REV-D1.sldprt, CUI_DEVICES_AMT-Sleeve-REV-D(3 mm).sldprt, CUI_DEVICES_AMT10X-Shaft-Adaptor-REV-E.sldprt, CUI_DEVICES_Receiver-board.sldprt]
2023-09-13 nonfunctional part updates due to soldiworks update
    [25d-metal-gearmotor-34-47-encoder.step.SLDPRT, 5544T231_Tight-Tolerance 12L14 Carbon Steel Rod.SLDPRT, 8mm_bearing.SLDPRT, 91290A111_Alloy Steel Socket Head Screw.SLDPRT, CUI_DEVICES_AMT-103-Base-REV-K(Default).sldprt, CUI_DEVICES_AMT-103-Top-Cover-REV-I.sldprt, CUI_DEVICES_AMT-Hub-Bottom-REV-B.sldprt, CUI_DEVICES_AMT-Hub-Top-REV-D1.sldprt]
2023-10-03 furuta_pendulum.ino - fix current observer - fix arm 2 reference - adjust controller pars
    ideas.txt
    - delete because all moved to github issues
    - observer and controller drawings for learning
    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
    [furuta-pendulum.ino]
2023-10-04 Rewrite digital observer simulation, print out A and C matrices instead of A_1
2025-07-25 Start pcb development
    [LM78L05ACZ_NOPB.step, furuta-pendulum-pcb.kicad_pcb, furuta-pendulum-pcb.kicad_sch]
2025-10-15 update pcb files
    [furuta-pendulum-pcb.kicad_pcb, furuta-pendulum-pcb.kicad_sch]
2025-10-15 add current sensor breakout board
    [furuta-pendulum-pcb.kicad_pcb, furuta-pendulum-pcb.kicad_sch]
2025-10-16 create pcb traces, add mounting holes
    [furuta-pendulum-pcb.kicad_pcb, furuta-pendulum-pcb.kicad_sch]
2025-10-21 add notebook for pcb calculations
2025-10-28 complete 5V current and power calculator
2025-12-10 board updates
    [furuta-pendulum-pcb.kicad_pcb]
2025-12-18 heatsink sizing math, small schematic renames and moves
    [furuta-pendulum-pcb.kicad_sch]
